w3arycod3r/neodriver-ornament/img/bb_test1.jpg

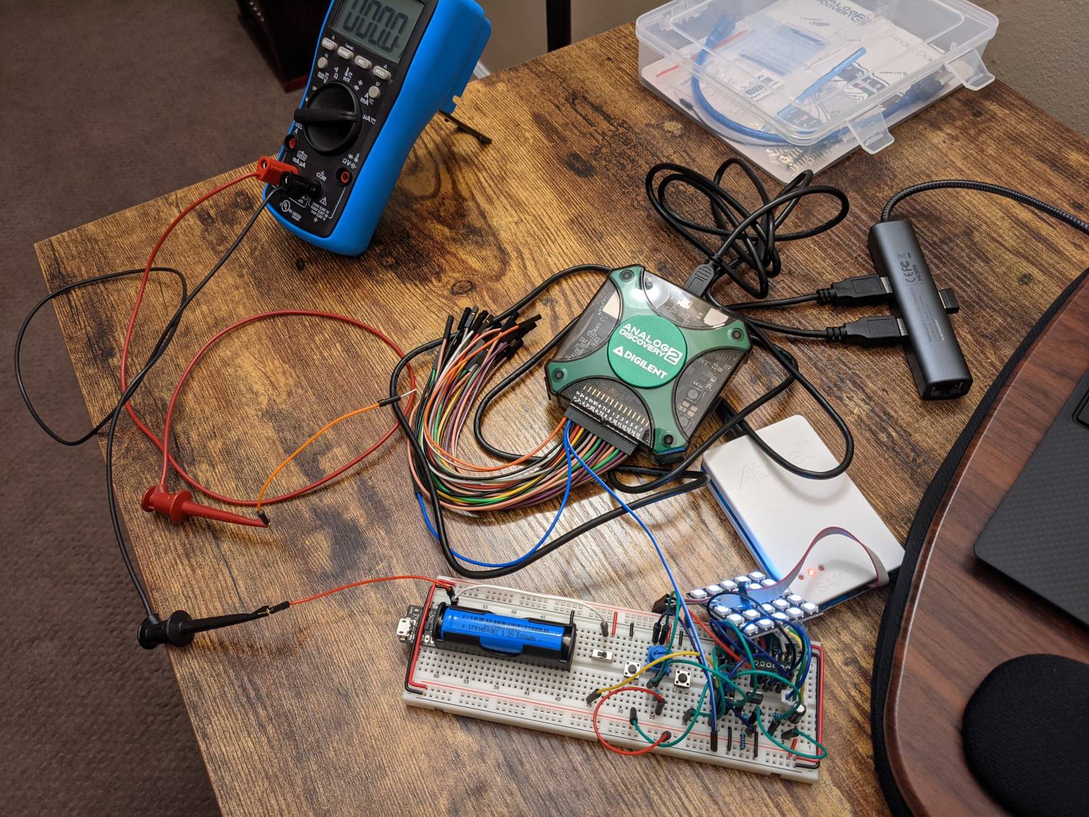
img/bb_test1.jpg
