w3arycod3r/neodriver-ornament/img/test1.jpg

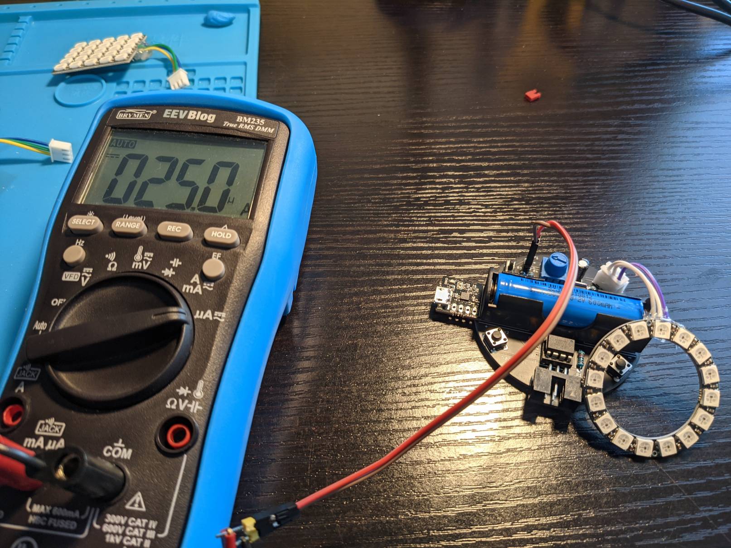
img/test1.jpg
