w3arycod3r/neodriver-ornament/kicad/export/pdf/Neo_Driver v03 Schematic.pdf

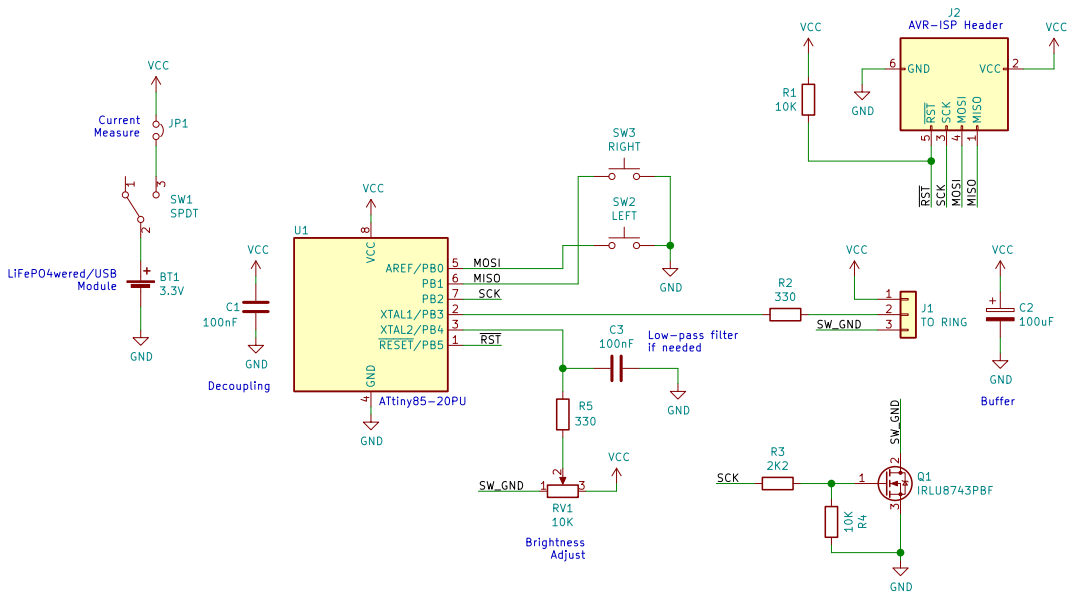
[picture p32: page 1]

AVR-ISP Header LiFePO4wered/USB Module

License: CC BY 4.0 Author: Garrett Carter

File: Neo_Driver.sch Sheet: / creativecommons.org/licenses/by/4.0

Id: 1/1 Title: Neo Driver
