w3arycod3r/neodriver-ornament/kicad/export/pdf/Neo_Driver v02 PCB.pdf

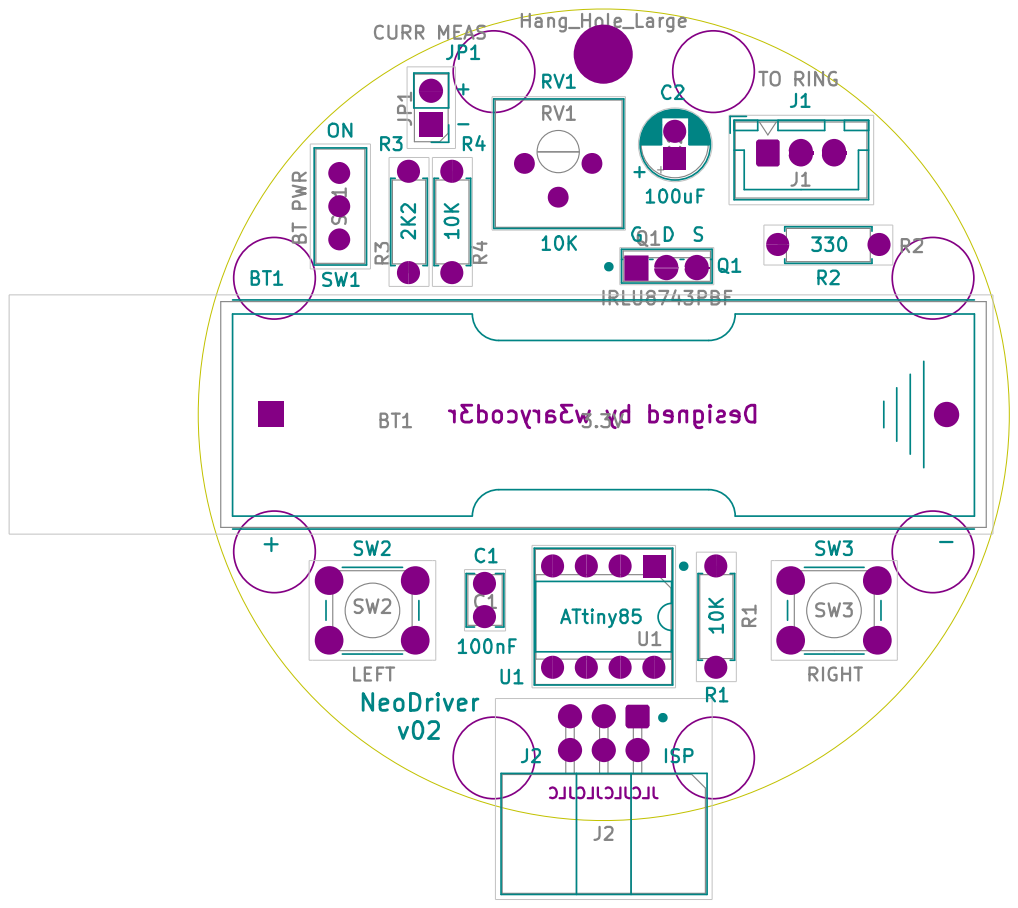
[picture p33: page 1]
