w3arycod3r/neodriver-ornament/kicad/Neo_Driver/Neo_Driver.kicad_pcb

## KiCad design kicad/Neo_Driver/Neo_Driver.kicad_pcb (2021-12-10)

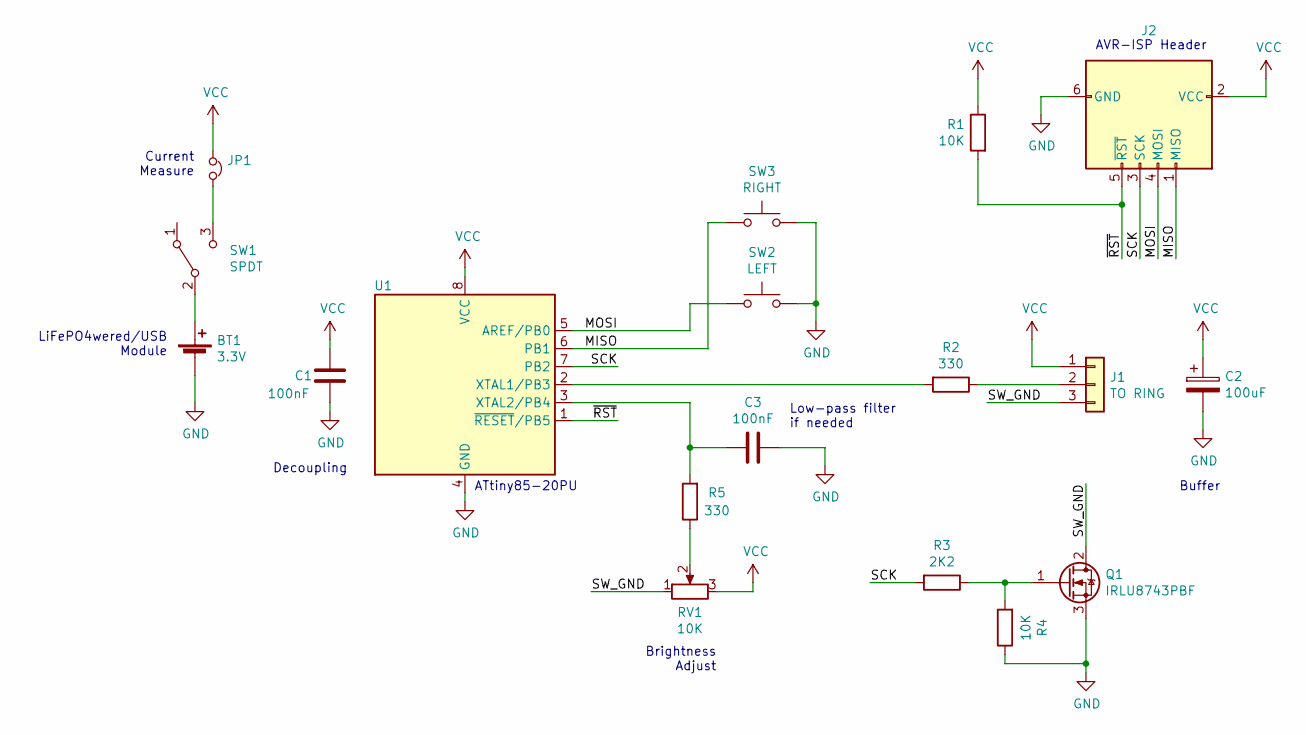
[picture p34: schematic Neo_Driver.sch, Neo Driver]

Parts:
BT1: 3.3V; LiFePO4wered_USB_Slim
C1, C3: 100nF; C_Disc_D3.8mm_W2.6mm_P2.50mm
C2: 100uF; CP_Radial_D5.0mm_P2.00mm
J1: TO RING; JST_XH_B3B-XH-A_1x03_P2.50mm_Vertical
J2: ISP; IDC-Header_2x03_P2.54mm_Horizontal
JP1: CURR MEAS; PinHeader_1x02_P2.54mm_Vertical
Q1: IRLU8743PBF; TO-251-3_Vertical
R1, R4: 10K; R_Axial_DIN0207_L6.3mm_D2.5mm_P7.62mm_Horizontal
R2, R5: 330; R_Axial_DIN0207_L6.3mm_D2.5mm_P7.62mm_Horizontal
R3: 2K2; R_Axial_DIN0207_L6.3mm_D2.5mm_P7.62mm_Horizontal
RV1: 10K; Potentiometer_Bourns_3386P_Vertical
SW1: SPDT; SW_Slide_SPDT_8.6x3.7mm_P2.50mm
SW2: LEFT; SW_PUSH_6mm_H5mm
SW3: RIGHT; SW_PUSH_6mm_H5mm
U1: ATtiny85; DIP-8_W7.62mm_Socket

Connections:
/MISO: J2.1 (MISO), SW3.1, U1.6 (PB1)
/MOSI: J2.4 (MOSI), SW2.1, U1.5 (AREF/PB0)
/SCK: J2.3 (SCK), R3.2, U1.7 (PB2)
/SW_GND: J1.3, Q1.2 (D), RV1.1
/~RST: J2.5 (~RST), R1.2, U1.1 (~RESET~/PB5)
GND: BT1.2 (-), C1.2, C2.2, C3.1, J2.6 (GND), Q1.3 (S), R4.1, SW2.2, SW3.2, U1.4 (GND)
unnamed: BT1.1 (+), SW1.2 (B)
unnamed: C3.2, R5.2, U1.3 (XTAL2/PB4)
unnamed: J1.2, R2.1
unnamed: JP1.2, SW1.3 (C)
unnamed: Q1.1 (G), R3.1, R4.2
unnamed: R2.2, U1.2 (XTAL1/PB3)
unnamed: R5.1, RV1.2
VCC: C1.1, C2.1, J1.1, J2.2 (VCC), JP1.1, R1.1, RV1.3, U1.8 (VCC)

Notes on the sheet:
Decoupling
Buffer
Low-pass filter if needed
LiFePO4wered/USB Module
Brightness Adjust
Current Measure
ATtiny85-20PU
AVR-ISP Header

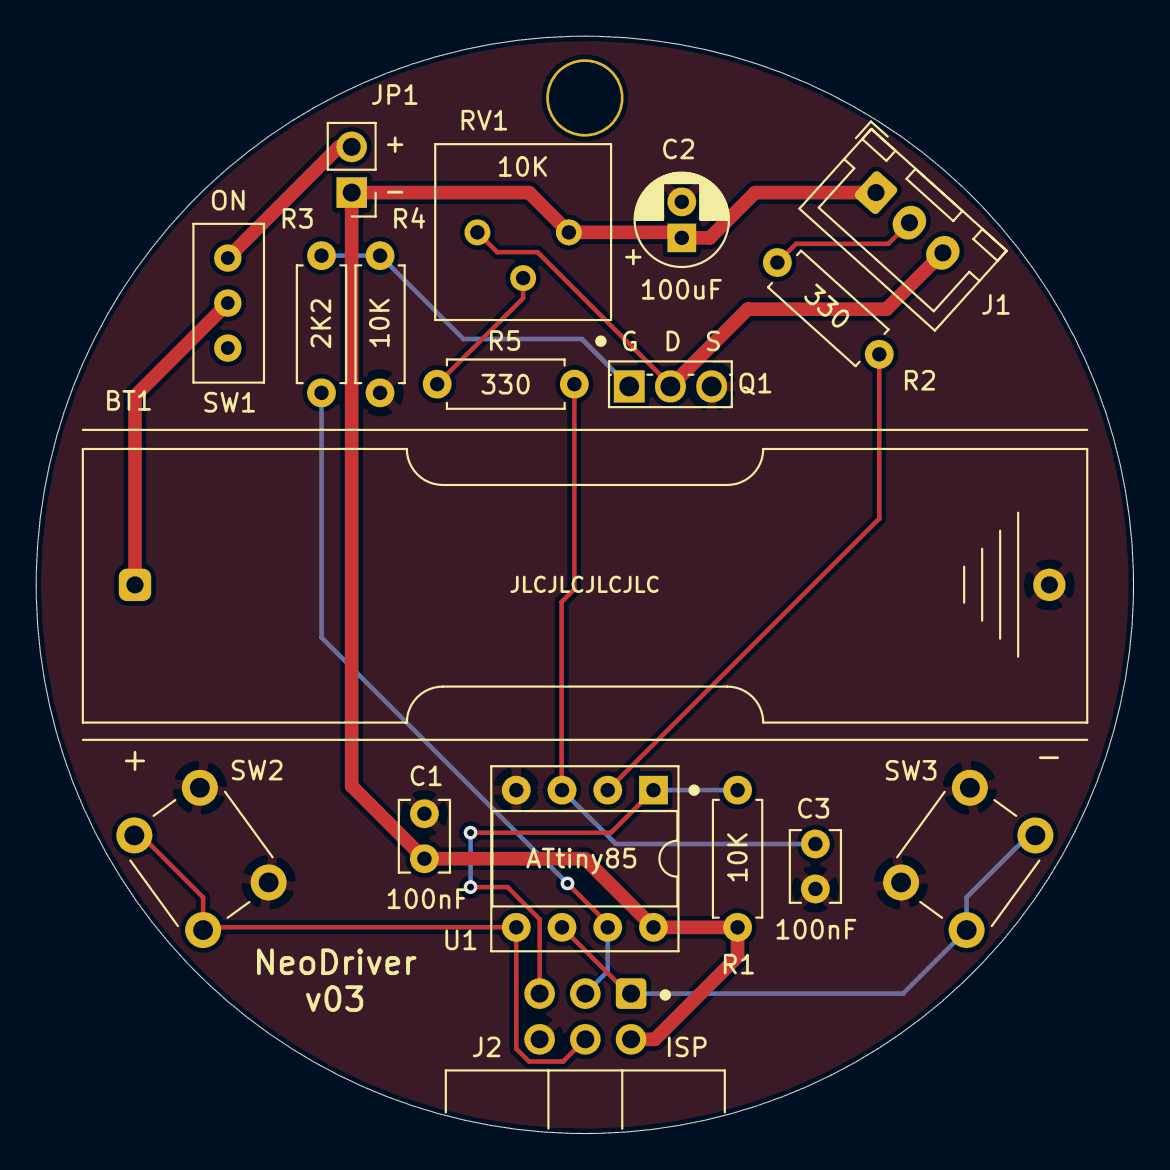
[picture p35: board Neo_Driver.kicad_pcb from above]

Board: 2 copper layers, 61.0 x 61.0 mm, 18 parts (0 on the bottom side), 14 nets.
