w3arycod3r/neodriver-ornament/arduino/neo_driver_app/neo_driver_app.ino

/* File:      neo_driver_app.ino
 * Author:    Garrett Carter
 * Purpose:   Main NeoPixel driver program.
 */

/*
 *  FUSE SETTINGS:
 *  EESAVE    ENABLE
 *  BODLEVEL  ENABLE at VCC = 1.8V
 *  CKDIV8    DISABLE
 *  SUT_CKSEL INTRCOSC_8MHZ_6CK_14CK_64MS
 *
 *  EXTENDED  0xFF
 *  HIGH      0xD6
 *  LOW       0xE2
 */

/********************************* INCLUDES **********************************/
#include <Arduino.h>
#include <EEPROM.h>
#include <avr/power.h>
#include <avr/interrupt.h>
#include <avr/sleep.h>
#include <avr/wdt.h>
#include "neo_pixel_slim.h"
#include "multi_button.h"
#include <neo_common.h>

/*********************************** ENUMS ***********************************/
typedef enum { SYS_MODE_ANIM_SEL,       // Play one selected animation.
               SYS_MODE_ANIM_SHUFF,     // "Shuffle mode". Play randomly selected animations in turn.
               SYS_MODE_PIX_ADJ,        // Adjust number of pixels.
} _SYS_MODE_T;

typedef enum { FRAMES_MODE_STATIC,      // Sprite is stationary. Length determined by repeat count.
               FRAMES_MODE_SHIFT,       // Shift the sprite. Anim is terminated when sprite goes offscreen.
} _FRAMES_MODE_T;

/********************************** STRUCTS **********************************/
typedef struct {
    uint16_t u16_frameStep_msec;  // "on" time for each frame in the sequence.
    uint32_t u32_color;           // Color. Set to 0 for dynamic effect.
    uint8_t* pu8_frames;          // Pointer to the frame sequence array stored in flash.
    uint8_t  u8_mode;             // Mode of operation. A value from _FRAMES_MODE_T.

    // STATIC mode params
    uint8_t  u8_seqRepeatCnt;     // Number of times to repeat the frame seq for each anim cycle in STATIC mode.
    
    // SHIFT mode params
    uint8_t  u8_frameShiftSync;   // Number of frames between shifts, in SHIFT mode.
    int8_t   i8_startPosX;        // Init X,Y position. Should start onscreen.
    int8_t   i8_startPosY;        // 
    int8_t   i8_shiftStepX;       // The X shift to perform on each shift step. Can be pos, neg, or zero.
    int8_t   i8_shiftStepY;       // The Y shift to perform on each shift step. Can be pos, neg, or zero.
    
} FRAMES_CONFIG_T;

/********************************** DEFINES **********************************/

// Watchdog timeouts (Actual delays will be slightly longer at 3.3V)
#define WDT_16MS   0
#define WDT_32MS   1
#define WDT_64MS   2
#define WDT_125MS  3
#define WDT_250MS  4
#define WDT_500MS  5
#define WDT_1S     6
#define WDT_2S     7
#define WDT_4S     8
#define WDT_8S     9  // Hardware maximum

// Multiples of 8 sec, software generated
#define WDT_16S    10
#define WDT_24S    11
#define WDT_32S    12
#define WDT_40S    13
#define WDT_48S    14
#define WDT_56S    15

// Battery params
#define BATT_TON_MSEC         2000    // "On" time for low battery timer
#define BATT_DISCHG_THRESH_MV 2500    // Discharge threshold (Cutoff volt. from datasheet = 2.0V)
#define BATT_CHG_THRESH_MV    3000    // Charge threshold (Cutoff volt. from datasheet = 2.0V)

#define BATT_LVL_THRESH_1_MV 2750
#define BATT_LVL_THRESH_2_MV 3000
#define BATT_LVL_THRESH_3_MV 3100
#define BATT_LVL_THRESH_4_MV 3200
#define BATT_LVL_STEP_MSEC   400
#define BATT_LVL_SLEEP_TIME  WDT_8S

#define BATT_ICON_LVL_1     '#'
#define BATT_ICON_LVL_2     '$'
#define BATT_ICON_LVL_3     '%'
#define BATT_ICON_LVL_4     '&'
#define BATT_ICON_LVL_5     '\''
#define BATT_ICON_DEAD      '('

// Pixel params
#define BRIGHT_MIN   24
#define BRIGHT_INIT  8
#define PIX_CNT_MIN  1
#define PIX_CNT_MAX  25
#define PIX_CNT_INIT 25

// Animation params
#define ANIM_CNT (sizeof(apfn_renderFunc) / sizeof(apfn_renderFunc[0]))
#define ANIM_MANUAL_CYCLES     1              // Number of cycles to play in "manual" mode before going to shuffle mode

// Primaries
#define PRIM_ON_TIME_MSEC      6000           // "on" time between sleeps
#define PRIM_SLEEP_TIME        WDT_8S         // Time to sleep after this anim

// Colorwheel
#define COL_WHEEL_ON_TIME_MSEC 6000
#define COL_WHEEL_SLEEP_TIME   WDT_8S

// Half
#define HALF_ON_TIME_MSEC      6000
#define HALF_SLEEP_TIME        WDT_8S

// Sparkle
#define SPK_STEP_MSEC          65             // Time between random pixel change
#define SPK_ON_TIME_MSEC       4000
#define SPK_SLEEP_TIME         WDT_8S

// Marquee
#define MARQUEE_ON_TIME_MSEC   6000
#define MARQUEE_SLEEP_TIME     WDT_8S

// Sine Gamma
#define SINE_ON_TIME_MSEC      6000
#define SINE_SLEEP_TIME        WDT_8S

// CoV
#define COV_STEP_MSEC          1000                   // "On" time for each base
#define COV_STEP_CNT           4                      // Number of steps (bases) per cycle
#define COV_BASES_CNT         (EEP_COV_DATA_NUM_BYTES * 4)     // 4 bases per byte
#define COV_SLEEP_TIME         WDT_8S

// Message Scroll
#define MSG_STEP_MSEC          200                    // Time to shift each char left by one pixel
#define MSG_SLEEP_TIME         WDT_24S

// Frames
#define FRAMES_SLEEP_TIME      WDT_8S

/*
 *   ANIM_ROT_SEL - Rotation select for 5x5 Matrix - Increasing #, Turning clockwise
 *   Used by several text based animations
 *
 *   Value |  Input wires located at:
 *   ================================
 *   1     |  BOTTOM
 *   2     |  LEFT
 *   3     |  TOP
 *   4     |  RIGHT
 */
#define ANIM_ROT_SEL 3

// I/O Mapping
#define IO_SW_LEFT       BIT0 // PB0, AREF - Left switch
#define IO_SW_RIGHT      BIT1 // PB1       - Right switch
#define IO_NP_ENABLE     BIT2 // PB2, ADC1 - NeoPixel Enable
#define IO_NP_ENABLE_ADC A1
#define IO_NP_DATA       BIT3 // PB3, ADC3 - NeoPixel Data
#define IO_NP_DATA_ADC   A3
#define IO_POT_ADC       A2   // PB4, ADC2 - Brightness Potentiometer
                              // PB5, ADC0 - Reset

/******************************* DEBUG PARAMS ********************************/
#define DEBUG_COV_ANIM  0
#define DEBUG_LOW_BATT  0
#define DEBUG_BATT_LVL  0
#define DEBUG_ADC_VAL   0
#define DEBUG_RAND_SEED 0
#define DEBUG_BRIGHT    0

// Debug CoV animation
#if DEBUG_COV_ANIM == 1
    #define COV_BASES_CNT  10
    #define COV_STEP_MSEC  1000
    #define COV_SLEEP_TIME WDT_125MS
#endif

// Debug low battery
#if DEBUG_LOW_BATT == 1
    #define BATT_TON_MSEC  2000
    #define BATT_DISCHG_THRESH_MV 1000
#endif

// Debug batt level animation
#if DEBUG_BATT_LVL == 1
    #define SPOOF_BATT_LVL 3200
#endif

// Debug brightness
#if DEBUG_BRIGHT == 1
    #define BRIGHT_MIN  0
#endif

/******************************** PROTOTYPES *********************************/
void randomize_anim();
void mode_logic();

void anim_off();
void anim_white();
void anim_primaries();
void anim_colorwheel_gamma();
void anim_half();
void anim_sparkle();
void anim_marquee();
void anim_sine_gamma();
void anim_cov_quar();
void anim_cov_char();
void anim_cov(uint8_t u8_pattType);
void anim_msg_1();
void anim_msg_2();
void anim_msg_3();
void anim_msg_4();
void anim_msg(uint8_t* pu8_msg, uint32_t u32_color=0);
void anim_frames_1();
void anim_frames_2();
void anim_frames_3();
void anim_frames_4();
void anim_frames_5();
void anim_frames_6();
void anim_frames_7();
void anim_frames_8();
void anim_frames_9();
void anim_frames_10();
void anim_frames(FRAMES_CONFIG_T* pst_f);
void anim_batt_level();

ISR(PCINT0_vect);
ISR(WDT_vect);

uint8_t get_batt_level();
void draw_value(uint32_t u32_val, uint32_t u32_maxVal);
void draw_value_binary(uint32_t u32_val);
void check_batt(uint16_t u16_batt_mv);
void enable_pc_ints();
void disable_pc_ints();
void shutdown();
void anim_low_batt();
uint8_t extract_digit(uint16_t u16_val, uint8_t u8_dig);
void anim_voltage(uint16_t u16_mv);
void anim_color_wipe(uint32_t u32_color, uint16_t u16_wait);
void anim_color_count(uint32_t u32_color, uint16_t u16_wait, uint16_t u16_count);
uint16_t read_vcc_mv();
uint8_t read_cov_base(uint16_t u16_baseNum);
void draw_char(char c_char, uint32_t u32_color, int8_t i8_x=0, int8_t i8_y=0);
void wd_enable(uint8_t u8_timeout);
void _wd_hw_enable(uint8_t u8_timeout);
void store_rand_seed();

/****************************** FLASH CONSTANTS ******************************/

// Message Strings
const char PROGMEM sz_msg1[] = "W3ARYCOD3R ";
const char PROGMEM sz_msg2[] = "MERRY XMAS! ";
const char PROGMEM sz_msg3[] = "HAPPY NEW YEAR! ";
const char PROGMEM sz_msg4[] = "u 4 8 15 16 23 42 ";    // Lost "numbers"
// const char PROGMEM sz_msg4[] = "2021 FTW! ";


// Frame ASCII sequences
const char PROGMEM sz_frames1[] = "gh";            // Pacman    ( 12   : gh  )
const char PROGMEM sz_frames2[] = "\"";            // Ghost     ( 1    : "   )
const char PROGMEM sz_frames3[] = "jklmnopq";      // Starburst ( 12345678 : jklmnopq)
const char PROGMEM sz_frames4[] = "rs";            // Frog      ( 12   :  rs )
const char PROGMEM sz_frames5[] = "`a";            // Turbine   ( 12   :  `a )
const char PROGMEM sz_frames6[] = "b/-\\";         // Spinner
const char PROGMEM sz_frames6_alt[] = "\\-/b";     // Spinner ALT
const char PROGMEM sz_frames7[] = "ef";            // DNA       ( 12    :  ef    )
const char PROGMEM sz_frames8[] = ")*+,.";         // Snowfall  ( 12345 :  )*+,. )
const char PROGMEM sz_frames9[] = ":@=[=;";        // Field     ( 12345  :  :;=@[  ) [143532]
const char PROGMEM sz_frames10[] = "]_cdcit";      // Ball      ( 123467 :  ]_cdit )
const char PROGMEM sz_frames10_alt[] = "ticdc_]";  // Ball ALT

/******************************** GLOBAL VARS ********************************/

// uint16_t u16_frameStep_msec;  // "on" time for each frame in the sequence.
// uint32_t u32_color;           // Color. Set to 0 for dynamic effect.
// uint8_t* pu8_frames;          // Pointer to the frame sequence array stored in flash.
// uint8_t  u8_mode;             // Mode of operation. A value from _FRAMES_MODE_T.

// // STATIC mode params
// uint8_t  u8_seqRepeatCnt;     // Number of times to repeat the frame seq for each anim cycle in STATIC mode.

// // SHIFT mode params
// uint8_t  u8_frameShiftSync;   // Number of frames between shifts, in SHIFT mode.
// int8_t   i8_startPosX;        // Init X,Y position. Should start onscreen.
// int8_t   i8_startPosY;        // 
// int8_t   i8_shiftStepX;       // The X shift to perform on each shift step. Can be pos, neg, or zero.
// int8_t   i8_shiftStepY;       // The Y shift to perform on each shift step. Can be pos, neg, or zero.

// Frame sequence config data

// Sequence 1 - Pacman
FRAMES_CONFIG_T st_sequence1 = {
    200,
    COLOR_YELLOW,
    sz_frames1,
    FRAMES_MODE_SHIFT,

    // STATIC params
    0,

    // SHIFT params
    2,
    -4,
    0,
    1,
    0
};

// Sequence 2 - Ghost
FRAMES_CONFIG_T st_sequence2 = {
    250,
    COLOR_TEAL,
    sz_frames2,
    FRAMES_MODE_SHIFT,

    // STATIC params
    0,

    // SHIFT params
    1,
    -4,
    0,
    1,
    0
};

// Sequence 3 - Starburst
FRAMES_CONFIG_T st_sequence3 = {
    100,
    COLOR_WHEEL,
    sz_frames3,
    FRAMES_MODE_STATIC,

    // STATIC params
    1,

    // SHIFT params
    0,
    0,
    0,
    0,
    0
};

// Sequence 4 - Frog
FRAMES_CONFIG_T st_sequence4 = {
    250,
    COLOR_GREEN,
    sz_frames4,
    FRAMES_MODE_SHIFT,

    // STATIC params
    0,

    // SHIFT params
    1,
    -4,
    0,
    1,
    0
};

// Sequence 5 - Turbine
FRAMES_CONFIG_T st_sequence5 = {
    250,
    COLOR_WHEEL,
    sz_frames5,
    FRAMES_MODE_STATIC,

    // STATIC params
    7,

    // SHIFT params
    0,
    0,
    0,
    0,
    0
};

// Sequence 6 - Spinner
FRAMES_CONFIG_T st_sequence6 = {
    250,
    COLOR_WHEEL,
    sz_frames6,
    FRAMES_MODE_STATIC,

    // STATIC params
    7,

    // SHIFT params
    0,
    0,
    0,
    0,
    0
};

// Sequence 7 - DNA
FRAMES_CONFIG_T st_sequence7 = {
    250,
    COLOR_WHEEL,
    sz_frames7,
    FRAMES_MODE_STATIC,

    // STATIC params
    6,

    // SHIFT params
    0,
    0,
    0,
    0,
    0
};

// Sequence 8 - Snowfall
FRAMES_CONFIG_T st_sequence8 = {
    300,
    COLOR_TEAL,
    sz_frames8,
    FRAMES_MODE_STATIC,

    // STATIC params
    4,

    // SHIFT params
    0,
    0,
    0,
    0,
    0
};

// Sequence 9 - Field
FRAMES_CONFIG_T st_sequence9 = {
    400,
    COLOR_WHEEL,
    sz_frames9,
    FRAMES_MODE_STATIC,

    // STATIC params
    5,

    // SHIFT params
    0,
    0,
    0,
    0,
    0
};

// Sequence 10 - Ball
FRAMES_CONFIG_T st_sequence10 = {
    150,
    COLOR_YELLOW,
    sz_frames10,
    FRAMES_MODE_STATIC,

    // STATIC params
    1,

    // SHIFT params
    0,
    0,
    0,
    0,
    0
};

// Misc vars
uint8_t u8_anim = 0;                   // Index of current anim in table
uint8_t u8_mode = SYS_MODE_ANIM_SEL;   // Current mode
uint16_t au16_pow10[] = { 1, 10, 100, 1000, 10000 }; // Powers of 10 used for B2D
bool b_animReset = true;               // Used to inform animations to reset
bool b_animCycleComplete = false;      // Signal from animations to mode logic
uint8_t au8_pixelData[PIX_CNT_MAX*3];  // 3 bytes of color data per pixel
uint32_t u32_randSeed;
volatile uint8_t u8_wdtCounter = 0;    // Used in WDT ISR
uint8_t u8_nextSleepTime = WDT_16MS;
volatile bool b_pinChangeWake = false; // Signal from pin change ISR to mode logic

// "noinit" section. Vars in this section are not cleared to zero at startup.

// Array of function pointers, in order of cycle
void (*apfn_renderFunc[])(void) {
    //anim_off,
    //anim_white,
    anim_primaries, anim_colorwheel_gamma,
    // anim_half,
    anim_sparkle,
    // anim_marquee, anim_sine_gamma,
    // anim_cov_quar,
    anim_cov_char,
    anim_msg_1,
    anim_msg_2,
    anim_msg_3,
    anim_msg_4,
    anim_frames_1,
    anim_frames_2,
    anim_frames_3,
    anim_frames_4,
    anim_frames_5,
    anim_frames_6,
    anim_frames_7,
    anim_frames_8,
    anim_frames_9,
    anim_frames_10,
    anim_batt_level,
};

/****************************** GLOBAL OBJECTS *******************************/
NeoPixel_Slim o_strip(au8_pixelData, PIX_CNT_MAX, PIX_CNT_INIT, IO_NP_DATA);
multiButton o_leftBtn, o_rightBtn;

/****************************** SETUP FUNCTION *******************************/
void setup() {
    // Disable unused peripherals to save power in ACTIVE mode

    // The below assignments should be equivalent to RESET values
    // TCCR1 = 0;                                                     // Disable TIMER1
    // GTCCR = 0;                                                     // Disable TIMER1
    // bitClearMask( TIMSK, _BV(OCIE1A) | _BV(OCIE1B) | _BV(TOIE1) ); // Disable all TIMER1 ints
    // PLLCSR = 0;                                                    // Disable PLL
    // USICR = 0;                                                     // Disable USI

    ACSR = _BV(ACD);                                               // Disable analog comparator
    bitSetMask( DIDR0, _BV(ADC2D) );                               // Disable digital input buffer on ADC2
    bitSetMask( PRR, _BV(PRTIM1) | _BV(PRUSI) );                   // Disable TIMER1, USI clocks

    // Read EEPROM settings data
    uint8_t u8_rPix = EEPROM.read(EEP_SETT_NPIX);
    uint8_t u8_rAnim = EEPROM.read(EEP_SETT_ANIM);
    EEPROM.get(EEP_SETT_RSEED, u32_randSeed);

    // Validate pixel count from EEPROM
    if (u8_rPix > PIX_CNT_MAX || u8_rPix < PIX_CNT_MIN) {
        u8_rPix = PIX_CNT_INIT;
        EEPROM.write(EEP_SETT_NPIX, u8_rPix);
    }

    // Validate animation number from EEPROM
    if (u8_rAnim >= ANIM_CNT) {
        u8_rAnim = 0;
        EEPROM.write(EEP_SETT_ANIM, u8_rAnim);
    }

    // Seed PRNG with a number derived from a source of entropy (human input)
    randomSeed(u32_randSeed ^ read_vcc_mv());
    
    // Update state using EEPROM data
    o_strip.update_length(u8_rPix);
    u8_anim = u8_rAnim;

    // Setup I/O
    bitSetMask(DDRB, IO_NP_ENABLE);               // Set as o/p
    bitSetMask(PORTB, IO_NP_ENABLE);              // Enable MOSFET for NeoPixel power
    delay(5);                                     // Time for MOSFET to switch on
    bitClearMask(DDRB, IO_SW_LEFT | IO_SW_RIGHT); // Set as i/p
    bitSetMask(PORTB, IO_SW_LEFT | IO_SW_RIGHT);  // Enable pull-ups

    // Init and clear NeoPixels
    o_strip.begin();
    o_strip.show();
    o_strip.set_brightness(BRIGHT_INIT);

    // Init Vars

    // Debug code
    #if DEBUG_ADC_VAL == 1
        while(1) {
            delay(250);
            analogReference(DEFAULT);
            //draw_value(analogRead(IO_POT_ADC), 1023);
            draw_value(read_vcc_mv(), 3500);
            o_strip.show();
        }
    #endif

    #if DEBUG_RAND_SEED == 1
        draw_value_binary(u32_randSeed ^ read_vcc_mv());
        o_strip.show();
        delay(3000);
    #endif
    

}

/********************************* MAIN LOOP *********************************/
void loop() {

    // Set brightness from potentiometer value
    uint16_t u16_potVal = analogRead(IO_POT_ADC);
    uint8_t u8_bright = o_strip.get_gamma_8(map(u16_potVal, 0, 1023, BRIGHT_MIN, 255)); // Scale value
    o_strip.set_brightness(u8_bright);

    // Monitor vcc for low batt condition
    check_batt(read_vcc_mv());

    // Update "random" counter based on human interface 
    if ( (!bitReadMask(PINB, IO_SW_LEFT)) || (!bitReadMask(PINB, IO_SW_RIGHT)) ) {
        u32_randSeed++;
    }

    mode_logic();

    if ( (u8_mode == SYS_MODE_ANIM_SEL) || (u8_mode == SYS_MODE_ANIM_SHUFF) ) {
        (*apfn_renderFunc[u8_anim])();    // Render one frame in current anim
        o_strip.show();                   // and update the NeoPixels to show it
    }
    if (u8_mode == SYS_MODE_PIX_ADJ) {
        o_strip.fill(0xFF0000);
        o_strip.show();
    }

}

void randomize_anim() {
    uint8_t u8_newAnim;

    // Pick a new random animation, different from the current one
    do { u8_newAnim = random(ANIM_CNT); } while (u8_newAnim == u8_anim);

    u8_anim = u8_newAnim;
    
    // Randomly shuffle animation parameters
    uint8_t u8_direction = random(2); // 0 or 1

    if (u8_direction) {

        // Reverse ghost direction
        st_sequence2.i8_startPosX = -st_sequence2.i8_startPosX;
        st_sequence2.i8_shiftStepX = -st_sequence2.i8_shiftStepX;

        // Reverse frog direction
        st_sequence4.i8_startPosX = -st_sequence4.i8_startPosX;
        st_sequence4.i8_shiftStepX = -st_sequence4.i8_shiftStepX;

        // Reverse spinner direction
        st_sequence6.pu8_frames = sz_frames6_alt;
        
        // Reverse ball direction
        st_sequence10.pu8_frames = sz_frames10_alt;

    } else {

        // Restore spinner direction
        st_sequence6.pu8_frames = sz_frames6;

        // Restore ball direction
        st_sequence10.pu8_frames = sz_frames10;
    }
}

void mode_logic() {
    static uint8_t u8_animCycleCount = 0;

    // Handle power down after an animation cycle
    if (b_animCycleComplete) {
        b_animCycleComplete = false;
        u8_animCycleCount++;

        wd_enable(u8_nextSleepTime); // Value set by the terminating animation
        shutdown();

        // Don't randomize if we woke with switch
        if (u8_mode == SYS_MODE_ANIM_SHUFF && !b_pinChangeWake) {
            randomize_anim();
        }
        b_pinChangeWake = false;
        b_animReset = true;
    }

    // Switch to shuffle mode after playing a few cycles of the manually selected anim
    if (u8_mode == SYS_MODE_ANIM_SEL && u8_animCycleCount == ANIM_MANUAL_CYCLES-1) {
        u8_mode = SYS_MODE_ANIM_SHUFF;
    }

    // Update button events
    uint8_t u8_lEvent = o_leftBtn.check(bitReadMask(PINB, IO_SW_LEFT));
    uint8_t u8_rEvent = o_rightBtn.check(bitReadMask(PINB, IO_SW_RIGHT));

    // Respond to left button events
    switch (u8_lEvent)
    {
    // Click
    case 1:

        if (u8_mode == SYS_MODE_ANIM_SEL || u8_mode == SYS_MODE_ANIM_SHUFF)
        {
            u8_mode = SYS_MODE_ANIM_SEL;
            u8_animCycleCount = 0;

            if (u8_anim) { u8_anim--; }               // Go to prior anim
            else         { u8_anim = ANIM_CNT - 1; }  // or "wrap around" to last anim

            b_animReset = true;

            EEPROM.update(EEP_SETT_ANIM, u8_anim);
            store_rand_seed();
        }

        if (u8_mode == SYS_MODE_PIX_ADJ)
        {
            // Reduce numPixels by 1
            uint8_t u8_numPix = o_strip.get_length();
            if (u8_numPix >= PIX_CNT_MIN + 1)  { u8_numPix -= 1; }
            else                               { u8_numPix = PIX_CNT_MIN; }

            o_strip.clear();
            o_strip.show();
            o_strip.update_length(u8_numPix);
        }

        break;
    // Double Click
    case 2:

        if (u8_mode == SYS_MODE_PIX_ADJ)
        {
            // Reduce numPixels by 4
            uint8_t u8_numPix = o_strip.get_length();
            if (u8_numPix >= PIX_CNT_MIN + 4)  { u8_numPix -= 4; }
            else                               { u8_numPix = PIX_CNT_MIN; }

            o_strip.clear();
            o_strip.show();
            o_strip.update_length(u8_numPix);
        }

        break;
    // Hold
    case 3:

        break;
    // Long Hold
    case 4:

        if (u8_mode == SYS_MODE_ANIM_SEL || u8_mode == SYS_MODE_ANIM_SHUFF) {
            u8_mode = SYS_MODE_PIX_ADJ;
        }
        else if (u8_mode == SYS_MODE_PIX_ADJ) {
            EEPROM.update(EEP_SETT_NPIX, o_strip.get_length());
            u8_mode = SYS_MODE_ANIM_SEL;
        }

        break;
    }

    // Respond to right button events
    switch (u8_rEvent)
    {
    // Click
    case 1:

        if (u8_mode == SYS_MODE_ANIM_SEL || u8_mode == SYS_MODE_ANIM_SHUFF)
        {
            u8_mode = SYS_MODE_ANIM_SEL;
            u8_animCycleCount = 0;

            if (u8_anim < (ANIM_CNT - 1)) { u8_anim++;   }  // Advance to next anim
            else                          { u8_anim = 0; }  // or "wrap around" to start

            b_animReset = true;

            EEPROM.update(EEP_SETT_ANIM, u8_anim);
            store_rand_seed();
        }

        if (u8_mode == SYS_MODE_PIX_ADJ)
        {
            // Increase numPixels by 1
            uint8_t u8_numPix = o_strip.get_length();
            if (u8_numPix <= PIX_CNT_MAX - 1)  { u8_numPix += 1; }
            else                               { u8_numPix = PIX_CNT_MAX; }

            o_strip.update_length(u8_numPix);
        }


        break;
    // Double Click
    case 2:

        if (u8_mode == SYS_MODE_PIX_ADJ)
        {
            // Increase numPixels by 4
            uint8_t u8_numPix = o_strip.get_length();
            if (u8_numPix <= PIX_CNT_MAX - 4)  { u8_numPix += 4; }
            else                               { u8_numPix = PIX_CNT_MAX; }

            o_strip.update_length(u8_numPix);
        }

        break;
    // Hold
    case 3:

        break;
    // Long Hold
    case 4:
        if (u8_mode == SYS_MODE_ANIM_SEL || u8_mode == SYS_MODE_ANIM_SHUFF) {
            u8_mode = SYS_MODE_PIX_ADJ;
        }
        else if (u8_mode == SYS_MODE_PIX_ADJ) {
            EEPROM.update(EEP_SETT_NPIX, o_strip.get_length());
            u8_mode = SYS_MODE_ANIM_SEL;
        }

        break;
    }
}

/***************************** RENDER FUNCTIONS ******************************/

// All NeoPixels off
void anim_off() {
    o_strip.clear();
}

void anim_white() {
    o_strip.fill(0xFFFFFF);
}

// Cycle through primary colors (red, green, blue), full brightness.
void anim_primaries() {
    static uint16_t u16_startTime;
    static uint8_t u8_direction;        // Direction of the anim. (0, 1 : CW, CCW)
    uint32_t u32_color;
    uint16_t u16_currTime = millis();
    uint16_t u16_currTimeMod = u16_currTime;
    uint8_t  u8_numPixels = o_strip.get_length();

    // Reset static vars to starting values
    if (b_animReset) {
        b_animReset = false;

        u16_startTime = u16_currTime;
        u8_direction = random(2); // 0 or 1
    }

    // For unsigned n-bit int i: -(i) = (2^n - i)
    // Negating this value will cause it to decrease instead of increase with time
    if (u8_direction) { u16_currTimeMod = -u16_currTimeMod; }

    // Generate time-modulated animation
    for (uint8_t u8_pixIdx = 0; u8_pixIdx < u8_numPixels; u8_pixIdx++) {
        uint8_t u8_pixIdxMod = u8_pixIdx;

        // Time modulated pixel index
        // Tick every 100 mSec
        u8_pixIdxMod = ((u16_currTimeMod / 100) + u8_pixIdxMod) % u8_numPixels;

        // Approx 1/3 R,G,B at any one time
        // Where does our modulated pixel index fall on the color wheel?
        if      (u8_pixIdxMod < u8_numPixels/3)    u32_color = 0xFF0000; // Red
        else if (u8_pixIdxMod < 2*u8_numPixels/3)  u32_color = 0x00FF00; // Green
        else                                       u32_color = 0x0000FF; // Blue
        o_strip.set_pix_color(u8_pixIdx, u32_color);
    }

    // Signal mode logic of cycle completion
    if (u16_currTime - u16_startTime > PRIM_ON_TIME_MSEC) {
        b_animCycleComplete = true;

        u8_nextSleepTime = PRIM_SLEEP_TIME;
    }
}

// Color wheel using gamma-corrected values.
void anim_colorwheel_gamma() {
    static uint16_t u16_startTime;
    static uint8_t u8_direction;        // Direction of the anim. (0, 1 : CW, CCW)
    uint16_t u16_currTime = millis();
    uint16_t u16_currTimeMod = u16_currTime;
    uint8_t  u8_numPixels = o_strip.get_length();

    // Reset static vars to starting values
    if (b_animReset) {
        b_animReset = false;

        u16_startTime = u16_currTime;
        u8_direction = random(2); // 0 or 1
    }

    // For unsigned n-bit int i: -(i) = (2^n - i)
    // Negating this value will cause it to decrease instead of increase with time
    if (u8_direction) { u16_currTimeMod = -u16_currTimeMod; }

    // Generate time-modulated animation
    for (uint8_t u8_pixIdx = 0; u8_pixIdx < u8_numPixels; u8_pixIdx++) {
        o_strip.set_pix_color(u8_pixIdx,
        o_strip.get_gamma_32(o_strip.hsv_to_pack((u16_currTimeMod * 50) + u8_pixIdx * 65536L / u8_numPixels)));
    }

    // Signal mode logic of cycle completion
    if (u16_currTime - u16_startTime > COL_WHEEL_ON_TIME_MSEC) {
        b_animCycleComplete = true;

        u8_nextSleepTime = COL_WHEEL_SLEEP_TIME;
    }
}

// Cycle with half the pixels on, half off at any given time.
void anim_half() {
    static uint16_t u16_startTime;
    static uint8_t u8_direction;        // Direction of the anim. (0, 1 : CW, CCW)
    uint16_t u16_currTime = millis();
    uint16_t u16_currTimeMod = u16_currTime;
    uint8_t  u8_numPixels = o_strip.get_length();

    // Reset static vars to starting values
    if (b_animReset) {
        b_animReset = false;

        u16_startTime = u16_currTime;
        u8_direction = random(2); // 0 or 1
    }

    // For unsigned n-bit int i: -(i) = (2^n - i)
    // Negating this value will cause it to decrease instead of increase with time
    if (u8_direction) { u16_currTimeMod = -u16_currTimeMod; }

    // Generate time-modulated animation
    for (uint8_t u8_pixIdx = 0; u8_pixIdx < u8_numPixels; u8_pixIdx++) {

        // Time modulated pixel index
        uint8_t u8_pixIdxMod = u16_currTimeMod/4 + u8_pixIdx * 256 / u8_numPixels;
        u8_pixIdxMod = (u8_pixIdxMod >> 7) * 255;                     // ON or OFF

        o_strip.set_pix_color(u8_pixIdx, u8_pixIdxMod * 0x010000);
    }

    // Signal mode logic of cycle completion
    if (u16_currTime - u16_startTime > HALF_ON_TIME_MSEC) {
        b_animCycleComplete = true;

        u8_nextSleepTime = HALF_SLEEP_TIME;
    }
}

// Sparkles. Randomly turns on ONE pixel at a time.
void anim_sparkle() {
    static uint16_t u16_startTime;
    static uint16_t u16_lastTime;
    static uint8_t  u8_pixIdx;
    static uint8_t  u8_red;
    static uint8_t  u8_green;
    static uint8_t  u8_blue;
    uint16_t u16_currTime = millis();
    uint8_t  u8_numPixels = o_strip.get_length();

    // Reset static vars to starting values
    if (b_animReset) {
        b_animReset = false;

        u16_startTime = u16_currTime;
        u16_lastTime = u16_currTime;
        u8_pixIdx = 0;

        // Pick a bright enough random color
        do {
            u8_red = random(256);
            u8_green = random(256);
            u8_blue = random(256);
        } while ((u8_red < 130) && (u8_green < 130) && (u8_blue < 130));
    }
    
    // Iterate animation once per step
    if (u16_currTime - u16_lastTime > SPK_STEP_MSEC) {
        u16_lastTime = u16_currTime;

        o_strip.clear();                             // Clear pixels

        uint8_t u8_newPixIdx;
        do { u8_newPixIdx = random(u8_numPixels); }  // Pick a new random pixel
        while (u8_newPixIdx == u8_pixIdx);           // but not the same as last time

        u8_pixIdx = u8_newPixIdx;                    // Save new random pixel index
        o_strip.set_pix_color(u8_pixIdx, u8_red, u8_green, u8_blue);
    }

    // Signal mode logic of cycle completion
    if (u16_currTime - u16_startTime > SPK_ON_TIME_MSEC) {
        b_animCycleComplete = true;

        u8_nextSleepTime = SPK_SLEEP_TIME;
    }
}

// Simple on-or-off "marquee" animation w/ about 50% of pixels lit at once.
void anim_marquee() {
    static uint16_t u16_startTime;
    static uint8_t u8_direction;        // Direction of the anim. (0, 1 : CW, CCW)
    uint16_t u16_currTime = millis();
    uint16_t u16_currTimeMod = u16_currTime;
    uint8_t  u8_numPixels = o_strip.get_length();

    // Reset static vars to starting values
    if (b_animReset) {
        b_animReset = false;

        u16_startTime = u16_currTime;
        u8_direction = random(2); // 0 or 1
    }

    // For unsigned n-bit int i: -(i) = (2^n - i)
    // Negating this value will cause it to decrease instead of increase with time
    if (u8_direction) { u16_currTimeMod = -u16_currTimeMod; }

    // Generate time-modulated animation
    for (uint8_t u8_pixIdx = 0; u8_pixIdx < u8_numPixels; u8_pixIdx++) {

        // Time modulated pixel index
        uint8_t u8_pixIdxMod = (u16_currTimeMod/4 + u8_pixIdx * 256 / u8_numPixels) & 0xFF;
        u8_pixIdxMod = ((u8_pixIdxMod >> 6) & 1) * 255;

        o_strip.set_pix_color(u8_pixIdx, u8_pixIdxMod * 0x000100L);
    }

    // Signal mode logic of cycle completion
    if (u16_currTime - u16_startTime > MARQUEE_ON_TIME_MSEC) {
        b_animCycleComplete = true;

        u8_nextSleepTime = MARQUEE_SLEEP_TIME;
    }
}

// Sine wave with gamma correction.
void anim_sine_gamma() {
    static uint16_t u16_startTime;
    static uint8_t u8_direction;        // Direction of the anim. (0, 1 : CW, CCW)
    uint16_t u16_currTime = millis();
    uint16_t u16_currTimeMod = u16_currTime;
    uint8_t  u8_numPixels = o_strip.get_length();

    // Reset static vars to starting values
    if (b_animReset) {
        b_animReset = false;

        u16_startTime = u16_currTime;
        u8_direction = random(2); // 0 or 1
    }

    // For unsigned n-bit int i: -(i) = (2^n - i)
    // Negating this value will cause it to decrease instead of increase with time
    if (u8_direction) { u16_currTimeMod = -u16_currTimeMod; }

    // Generate time-modulated animation
    for (uint8_t u8_pixIdx = 0; u8_pixIdx < u8_numPixels; u8_pixIdx++) {

        // Time modulated pixel index
        uint8_t u8_pixIdxMod = o_strip.get_sine_8((u16_currTimeMod/4 + u8_pixIdx * 512 / u8_numPixels) & 0xFF);
        u8_pixIdxMod = o_strip.get_gamma_8(u8_pixIdxMod);

        o_strip.set_pix_color(u8_pixIdx, u8_pixIdxMod * 0x000100L);
    }

    // Signal mode logic of cycle completion
    if (u16_currTime - u16_startTime > SINE_ON_TIME_MSEC) {
        b_animCycleComplete = true;

        u8_nextSleepTime = SINE_SLEEP_TIME;
    }
}


// Blink out the SARS-CoV-2 RNA sequence in a "quarter" pattern
void anim_cov_quar() {
    anim_cov(0);
}

// Blink out the SARS-CoV-2 RNA sequence using the charset
void anim_cov_char() {
    anim_cov(1);
}

/*!
 @brief             Supporting function for the CoV sequence animations
 @param u8_pattType 0 = Use "quarter" pattern,
                    1 = Use the charset to represent sequence letters
*/
void anim_cov(uint8_t u8_pattType) {
    static uint16_t u16_baseCnt = 0;
    static uint16_t u16_lastTime;
    static uint8_t  u8_stepCount;

    uint16_t u16_currTime = millis();

    // New transition into this anim, reset vars to starting values
    if (b_animReset) {
        b_animReset = false;

        // Don't reset baseCnt. Retain previous location in the sequence.

        u16_lastTime  = u16_currTime;
        u8_stepCount = 0;
    }

    // Map time elapsed 0-COV_STEP_MSEC (msec) to sine index 0-255
    uint8_t u8_cycle = (u16_currTime - u16_lastTime)*255L / COV_STEP_MSEC;

    // Shift sine wave right by 64 to get off-on-off cycle
    uint8_t u8_cBright = o_strip.get_gamma_8(o_strip.get_sine_8(u8_cycle - 64));

    o_strip.clear();
    uint8_t u8_numPixels = o_strip.get_length();
    uint8_t u8_quarter = u8_numPixels/4;                // Quarter of pixels

    // Render the quarter "slice" (or the char) for the current base, with sine-modulated brightness
    switch (read_cov_base(u16_baseCnt))
    {
    case 0: // A (Grn)
        if      (u8_pattType == 0) { o_strip.fill(u8_cBright * 0x000100L, 0, u8_quarter); }  // Force 32-bit mult
        else if (u8_pattType == 1) { draw_char('A', u8_cBright * 0x000100L); }
        break;
    case 1: // C (Blu)
        if      (u8_pattType == 0) { o_strip.fill(u8_cBright * 0x000001L, u8_quarter, u8_quarter); }
        else if (u8_pattType == 1) { draw_char('C', u8_cBright * 0x000001L); }
        break;
    case 2: // G (Yel)
        if      (u8_pattType == 0) { o_strip.fill(u8_cBright * 0x010100L, 2*u8_quarter, u8_quarter); }
        else if (u8_pattType == 1) { draw_char('G', u8_cBright * 0x010100L); }
        break;
    case 3: // U (Red)
        if      (u8_pattType == 0) { o_strip.fill(u8_cBright * 0x010000L, 3*u8_quarter, 0); }
        else if (u8_pattType == 1) { draw_char('U', u8_cBright * 0x010000L); }
        break;
    }

    // Current step complete
    if (u16_currTime - u16_lastTime > COV_STEP_MSEC) {

        // Prepare for next step. Increment base counter, wrap around if necessary
        u16_baseCnt++;
        if (u16_baseCnt == COV_BASES_CNT) { u16_baseCnt = 0; }
        u16_lastTime = u16_currTime;

        u8_stepCount++;

        // We have played enough steps, so signal cycle completion to the mode logic
        if (u8_stepCount == COV_STEP_CNT) {
            b_animCycleComplete = true;

            u8_nextSleepTime = COV_SLEEP_TIME;
        }
    }
}

// Message string 1
void anim_msg_1() {
    anim_msg(sz_msg1, 0xFF00FF);
}

// Message string 2
void anim_msg_2() {
    anim_msg(sz_msg2);
}

// Message string 3
void anim_msg_3() {
    anim_msg(sz_msg3);
}

// Message string 4
void anim_msg_4() {
    anim_msg(sz_msg4, COLOR_GREEN);
}

/*!
 @brief            Supporting function for the message scroll animations.
 @param pu8_msg    Starting address for a null-terminated C-String with the message, stored in flash.
 @param u32_color  Solid color to use for the characters. Leave at default 0 for a smooth color cycling anim.
*/
void anim_msg(uint8_t* pu8_msg, uint32_t u32_color) {
    static uint8_t  u8_charCnt; // Counts 0 to LEN-1, index into char array
    static uint8_t  u8_cIn;     // Incoming char
    static uint8_t  u8_cOut;    // Outgoing char
    static int8_t   i8_xIn;
    static int8_t   i8_xOut;
    static uint16_t u16_lastTime;
    static bool     b_readyToShutdown;

    uint16_t u16_currTime = millis();

    // New transition into this anim, reset all vars to starting values
    if (b_animReset) {
        b_animReset = false;
        u8_charCnt = 0;
        u8_cIn  = pgm_read_byte(&pu8_msg[0]);
        u8_cOut = ' ';
        i8_xIn  = 5;
        i8_xOut = 0;
        u16_lastTime  = u16_currTime;
        b_readyToShutdown = false;
    }

    // Iterate animation once per step
    if (u16_currTime - u16_lastTime >= MSG_STEP_MSEC) {
        u16_lastTime = u16_currTime;

        if (i8_xIn == 0) {     // Incoming char has reached middle
            u8_cOut = u8_cIn;  // Incoming becomes outgoing

            // Fetch next char
            u8_charCnt++;
            u8_cIn = pgm_read_byte(&pu8_msg[u8_charCnt]);

            // Reached null term, current cycle complete
            if (u8_cIn == 0) {

                b_readyToShutdown = true;
            }

            // Reset positions
            i8_xIn  = 6;
            i8_xOut = 0;
        }

        i8_xIn--; i8_xOut--;  // Shift both chars left
    }

    // Pick color to use
    uint32_t u32_c;
    if (u32_color == 0) { u32_c = o_strip.get_gamma_32(o_strip.hsv_to_pack(u16_currTime*10)); } // Smooth time-modulated color wheel
    else                { u32_c = u32_color; }                                                  // Solid color from calling func

    // Render characters at current pos
    o_strip.clear();
    draw_char(u8_cIn,  u32_c, i8_xIn);
    draw_char(u8_cOut, u32_c, i8_xOut);

    // Signal mode logic of cycle completion
    if (b_readyToShutdown) {
        b_readyToShutdown = false;
        b_animCycleComplete = true;

        u8_nextSleepTime = MSG_SLEEP_TIME;
    }
}

// Frames sequence 1
void anim_frames_1() {
    anim_frames(&st_sequence1);
}

// Frames sequence 2
void anim_frames_2() {
    anim_frames(&st_sequence2);
}

// Frames sequence 3
void anim_frames_3() {
    anim_frames(&st_sequence3);
}

// Frames sequence 4
void anim_frames_4() {
    anim_frames(&st_sequence4);
}

// Frames sequence 5
void anim_frames_5() {
    anim_frames(&st_sequence5);
}

// Frames sequence 6
void anim_frames_6() {
    anim_frames(&st_sequence6);
}

// Frames sequence 7
void anim_frames_7() {
    anim_frames(&st_sequence7);
}

// Frames sequence 8
void anim_frames_8() {
    anim_frames(&st_sequence8);
}

// Frames sequence 9
void anim_frames_9() {
    anim_frames(&st_sequence9);
}

// Frames sequence 10
void anim_frames_10() {
    anim_frames(&st_sequence10);
}

/*!
 @brief         Supporting function for the frames scroll animations.
 @param pst_f   Pointer to the structure containing frames configuration data.
*/
void anim_frames(FRAMES_CONFIG_T* pst_f) {
    static bool     b_readyToShutdown;
    static uint8_t  u8_frameIdx;     // Counts 0 to LEN-1, index into frames array
    static uint8_t  u8_frameShiftSync;
    static uint8_t  u8_seqRepeatCnt; // Counts how many frame seq's we have played
    static uint8_t  u8_currFrame;
    static uint16_t u16_lastFrameTime;
    static int8_t   i8_x;
    static int8_t   i8_y;

    uint16_t u16_currTime = millis();

    // New transition into this anim, reset static vars to starting values
    if (b_animReset) {

        b_animReset = false;
        b_readyToShutdown = false;
        u8_frameIdx = 0;
        u8_frameShiftSync = 0;
        u8_seqRepeatCnt = 0;
        u8_currFrame  = pgm_read_byte(&(pst_f->pu8_frames[0]));
        u16_lastFrameTime  = u16_currTime;

        // Set initial X and Y position of sprite
        if (pst_f->u8_mode == FRAMES_MODE_SHIFT) { i8_x = pst_f->i8_startPosX; i8_y = pst_f->i8_startPosY; }
        else                                     { i8_x =  0; i8_y = 0; }

    }

    // Time for frame update
    if (u16_currTime - u16_lastFrameTime >= pst_f->u16_frameStep_msec) {
        u16_lastFrameTime = u16_currTime;

        // Fetch next frame
        u8_frameIdx++;
        u8_currFrame = pgm_read_byte(&(pst_f->pu8_frames[u8_frameIdx]));

        // Reached null term, current frame cycle complete
        if (u8_currFrame == 0) {

            u8_seqRepeatCnt++;

            // We have repeated the seq the specified number of times
            if ((pst_f->u8_mode == FRAMES_MODE_STATIC) &&
                (u8_seqRepeatCnt == pst_f->u8_seqRepeatCnt)) {
                b_readyToShutdown = true;

            // Prepare for next frame seq
            } else {
                u8_frameIdx = 0;
                u8_currFrame = pgm_read_byte(&(pst_f->pu8_frames[0]));
            }
        }

        // Handle shift
        if (pst_f->u8_mode == FRAMES_MODE_SHIFT) {

            // Count frames and sync shift to frame transition
            u8_frameShiftSync++;
            if (u8_frameShiftSync == pst_f->u8_frameShiftSync) {
                u8_frameShiftSync = 0;

                // Update X and Y position
                i8_x += pst_f->i8_shiftStepX;
                i8_y += pst_f->i8_shiftStepY;
            }
            // We are offscreen, so animation is complete
            if ( (i8_x <= -5) || (i8_x >= 5) || (i8_y <= -5) || (i8_y >= 5) ) {
                b_readyToShutdown = true;
            }
        }
        
    }

    // Pick color to use
    uint32_t u32_color;
    if (pst_f->u32_color == COLOR_WHEEL) {
        u32_color = o_strip.get_gamma_32(o_strip.hsv_to_pack(u16_currTime*10)); // Smooth time-modulated color wheel
    } else {
        u32_color = pst_f->u32_color; // Solid color from spec
    }

    // Render frame
    o_strip.clear();
    draw_char(u8_currFrame, u32_color, i8_x, i8_y);

    // Signal mode logic of cycle completion
    if (b_readyToShutdown) {
        b_readyToShutdown = false;
        b_animCycleComplete = true;

        u8_nextSleepTime = FRAMES_SLEEP_TIME;
    }
}

void anim_batt_level() {
    static uint16_t u16_lastStepTime;
    static uint8_t u8_battLevel;
    static uint8_t u8_stepLevel;
    static bool    b_readyToShutdown;
    uint16_t u16_currTime = millis();

    // Reset static vars to starting values
    if (b_animReset) {
        b_animReset = false;

        u16_lastStepTime = u16_currTime;
        u8_battLevel = get_batt_level();
        u8_stepLevel = 1;
        b_readyToShutdown = false;
    }

    // Step the animation
    if (u16_currTime - u16_lastStepTime > BATT_LVL_STEP_MSEC) {
        u16_lastStepTime = u16_currTime;

        if (u8_stepLevel != u8_battLevel) {
            u8_stepLevel++;

        // Anim complete, power down
        } else {
            
            b_readyToShutdown = true;
        }
    }

    o_strip.clear();

    // Render current frame
    switch (u8_stepLevel)
    {
    case 1:
        draw_char(BATT_ICON_LVL_1, COLOR_RED);
        break;
    case 2:
        draw_char(BATT_ICON_LVL_2, COLOR_YELLOW);
        break;
    case 3:
        draw_char(BATT_ICON_LVL_3, COLOR_YELLOW);
        break;
    case 4:
        draw_char(BATT_ICON_LVL_4, COLOR_GREEN);
        break;
    case 5:
        draw_char(BATT_ICON_LVL_5, COLOR_GREEN);
        break;
    }

    // Signal mode logic of cycle completion
    if (b_readyToShutdown) {
        b_readyToShutdown = false;
        b_animCycleComplete = true;

        u8_nextSleepTime = BATT_LVL_SLEEP_TIME;
    }
}

/*********************************** ISR's ***********************************/

// Left or Right Switch
ISR(PCINT0_vect) {

    // Signal to mode logic
    b_pinChangeWake = true;

    // If we woke up with a switch, we don't want any additional WDT sleeps.
    u8_wdtCounter = 0;
}

// Watchdog timer
ISR(WDT_vect) {

    // Disable WDT interrupt
    bitClear(WDTCR, WDIE);
}

/***************************** SUPPORT FUNCTIONS *****************************/

// Return 1 to 5 corresponding to current battery level: 1 => empty, 5 => full.
uint8_t get_batt_level() {
    uint16_t u16_batt_mv = read_vcc_mv();

    // Determine battery level based on voltage ranges
    if (u16_batt_mv < BATT_LVL_THRESH_1_MV) {
        return 1;
    } else if ( (u16_batt_mv >= BATT_LVL_THRESH_1_MV) && (u16_batt_mv < BATT_LVL_THRESH_2_MV) ) {
        return 2;
    } else if ( (u16_batt_mv >= BATT_LVL_THRESH_2_MV) && (u16_batt_mv < BATT_LVL_THRESH_3_MV) ) {
        return 3;
    } else if ( (u16_batt_mv >= BATT_LVL_THRESH_3_MV) && (u16_batt_mv < BATT_LVL_THRESH_4_MV) ) {
        return 4;
    } else {
        return 5;
    }
}

// Display an integer value (0-maxVal) on the LEDs
void draw_value(uint32_t u32_val, uint32_t u32_maxVal) {

    // Linearly scale the value -> number of pixels to fill
    uint8_t u8_scaledVal = map(u32_val, 0, u32_maxVal, 0, o_strip.get_length());

    o_strip.clear();
    if (u8_scaledVal != 0)  { o_strip.fill(COLOR_PURPLE, 0, u8_scaledVal); }

}

void draw_value_binary(uint32_t u32_val) {
    o_strip.clear();

    // Represent each bit with an ON or OFF pixel, LSB first
    for (uint8_t u8_bit = 0; u8_bit < 32; u8_bit++) {

        // set_pix_color() will enforce pixel index bounds
        if (bitRead(u32_val, 0)) { o_strip.set_pix_color(u8_bit, COLOR_GREEN); }

        u32_val >>= 1;
    }
}

// Check battery level and respond to a low battery condition persisting for some time.
void check_batt(uint16_t u16_batt_mv) {
    static uint16_t u16_onTimeAcc = 0;
    static uint16_t u16_lastScan = 0;
    uint16_t u16_currTime = millis();
    uint8_t u8_statusFlags;
    bool b_shutdown = false;

    u8_statusFlags = EEPROM.read(EEP_SETT_FLAGS);

    // Has the low battery condition been previously detected?
    if (bitReadMask(u8_statusFlags, STAT_FLG_BATT_DEAD))
    {
        // Has battery level risen above the charge threshold?
        if (u16_batt_mv >= BATT_CHG_THRESH_MV)
        {
            // Clear Flag and continue
            EEPROM.update(EEP_SETT_FLAGS, bitClearMask(u8_statusFlags, STAT_FLG_BATT_DEAD));
        } else {
            // Shutdown
            b_shutdown = true;
        }
    }
    
    // Timer Running
    if (u16_batt_mv < BATT_DISCHG_THRESH_MV)
    {
        if (u16_lastScan)  u16_onTimeAcc += (u16_currTime - u16_lastScan);

        u16_lastScan = u16_currTime;
    }
    // Timer Reset
    else
    {
        u16_onTimeAcc = u16_lastScan = 0;
    }
    // Timer Done
    if (u16_onTimeAcc > BATT_TON_MSEC)
    {
        b_shutdown = true;
    }

    // Shutdown
    if (b_shutdown)
    {
        // Set the battery dead flag in EEPROM
        EEPROM.update(EEP_SETT_FLAGS, bitSetMask(u8_statusFlags, STAT_FLG_BATT_DEAD));

        anim_low_batt();
        shutdown();

        u16_onTimeAcc = u16_lastScan = 0; // Timer Reset
    }
    

}

void enable_pc_ints() {

    GIMSK |= _BV(PCIE);                 // Enable Pin Change Interrupts
    PCMSK |= _BV(PCINT0) | _BV(PCINT1); // Enable Specific Pins
}

void disable_pc_ints() {

    PCMSK = 0x00;                       // Disable All Pins
    GIMSK &= ~(_BV(PCIE));              // Disable Pin Change Interrupts
}

// Turn off LEDs and send ATtiny to sleep, waiting for interrupt (WDT or pin change) to wake
void shutdown() {

    o_strip.clear();
    o_strip.show();

    //DIDR0 |= (_BV(ADC2D));               // Disable digital input buffer for ADC2
    bitClearMask(DDRB, IO_NP_DATA          // Hi-Z to save power
                      |IO_NP_ENABLE);      // Hi-Z to turn off MOSFET
    bitSetMask(PORTB, IO_NP_DATA);         // Pull-up
    bitClearMask(PORTB, IO_NP_ENABLE);     // No Pull-up, there is external pull-down

    ADCSRA &= ~(_BV(ADEN));                // Disable ADC

    enable_pc_ints();                      // Wake-up Source
    set_sleep_mode(SLEEP_MODE_PWR_DOWN);
    sleep_enable();

    //sleep_bod_disable();                 // ATtiny85 Revision C or newer only
    sei();                                 // Global Interrupt Enable
    sleep_cpu();
    // Exec PC or WDT ISR, then return here

    // Handle additional WDT sleeps, if needed
    while (u8_wdtCounter > 0) {

        _wd_hw_enable(WDT_8S);
        //sleep_bod_disable();             // ATtiny85 Revision C or newer only
        sei();                             // Global Interrupt Enable
        sleep_cpu();
        // Exec PC or WDT ISR, then return here

        // Counter will be set to 0 if we woke by pin change.
        if (u8_wdtCounter == 0) { break; }

        u8_wdtCounter--;
    }
    
    sleep_disable();
    disable_pc_ints();                     // Don't want these during normal operation

    bitSetMask(DDRB, IO_NP_DATA            // Restore for NeoPixel Lib
                    |IO_NP_ENABLE);
    bitSetMask(PORTB, IO_NP_ENABLE);       // Enable power for NeoPixels
    ADCSRA |= _BV(ADEN);                   // Enable ADC

    // Reset the button state machines
    o_leftBtn.reset();
    o_rightBtn.reset();
}

// Quickly flash red battery icon to indicate low battery condition
void anim_low_batt() {

    o_strip.clear();
    for (uint8_t u8_i = 0; u8_i < 4; u8_i++)
    {
        draw_char(BATT_ICON_DEAD, COLOR_RED);
        o_strip.show();
        delay(200);

        o_strip.clear();
        o_strip.show();
        delay(200);
    }
}

// dig = 0 is LS digit
uint8_t extract_digit(uint16_t u16_val, uint8_t u8_dig) {
    return u16_val / au16_pow10[u8_dig] % 10 ;
}

// Flash the voltage with 3 digits of precision
void anim_voltage(uint16_t u16_mv) {

    for (uint8_t u8_dig = 3; u8_dig >= 1; u8_dig--) // Digits 3 to 1
    {
        uint8_t u8_digVal = extract_digit(u16_mv, u8_dig);
        anim_color_count(o_strip.rgb_to_pack(  0, 255,   0), 150, u8_digVal);
        delay(150 * u8_digVal);

        o_strip.clear();
        o_strip.show();
        delay(300);
    }
}


// Fill o_strip pixels one after another with a color, with a wait in between frames.
void anim_color_wipe(uint32_t u32_color, uint16_t u16_wait) {
    uint8_t u8_numPixels = o_strip.get_length();

    for (uint8_t u8_pixIdx = 0; u8_pixIdx < u8_numPixels; u8_pixIdx++) { // For each pixel in o_strip... 
        o_strip.set_pix_color(u8_pixIdx, u32_color);  //  Set pixel's color (in RAM)
        o_strip.show();                               //  Update o_strip to match
        delay(u16_wait);                              //  Pause for a moment
    }
}

// Fill o_strip pixels with a color, from 0 to count, with a wait in between frames.
void anim_color_count(uint32_t u32_color, uint16_t u16_wait, uint16_t u16_count) {

    for (uint8_t u8_pixIdx = 0; u8_pixIdx < u16_count; u8_pixIdx++) { //  For count # of pixels          
        o_strip.set_pix_color(u8_pixIdx, u32_color); //  Set pixel's color (in RAM)
        o_strip.show();                              //  Update o_strip to match
        delay(u16_wait);                             //  Pause for a moment
    }
}


// Read 1.1V reference against AVcc
uint16_t read_vcc_mv() {

    #if DEBUG_BATT_LVL == 1
        return SPOOF_BATT_LVL;
    #endif

    // Set the reference to Vcc and the measurement to the internal 1.1V reference
    ADMUX = _BV(MUX3) | _BV(MUX2);       // ATtiny85 specific

    delay(2);                            // Wait for Vref to settle
    ADCSRA |= _BV(ADSC);                 // Start conversion
    while (bit_is_set(ADCSRA, ADSC)) {}  // Measuring...

    uint8_t u8_low  = ADCL;              // Must read ADCL first - it then locks ADCH
    uint8_t u8_high = ADCH;              // Unlocks both

    uint16_t u16_result = ((u8_high << 8) | u8_low);

    u16_result = 1125300L / u16_result;  // Calculate Vcc (in mV); 1125300 = 1.1*1023*1000
    return u16_result;                   // Vcc in millivolts
}

// Extract base data from sequence table stored in EEPROM
uint8_t read_cov_base(uint16_t u16_baseNum) {

    // 0th base is encoded in the 2 most significant bits
    uint8_t u8_pos = 3 - u16_baseNum % 4;
    uint8_t u8_data = EEPROM.read(EEP_COV_DATA_START_ADDR + u16_baseNum/4);

    return (u8_data >> (2 * u8_pos)) & 0b00000011;
}

/*!
 @brief            Render an ASCII character onto a 5x5 NeoPixel matrix. Simply draws over the
                   current framebuffer. Destructive only to "on" bits in the font.
                   (X,Y) controls a shift of the char. (0,0) = no shift.
 @param c_char     ASCII character to render.
 @param u32_color  Color to use when setting bits.
 @param i8_x       X shift to perform. +X is right, -X is left. X <= -5 or X >= 5 is out of frame.
 @param i8_y       Y shift to perform. +Y is down, -Y is up. Y <= -5 or Y >= 5 is out of frame.
*/
void draw_char(char c_char, uint32_t u32_color, int8_t i8_x, int8_t i8_y) {

    // Enforce bounds of our ASCII char set
    if ((c_char < ASCII_START) || (c_char > ASCII_START + ASCII_NUM_CHARS - 1)) {
        return;
    }

    uint8_t au8_buffer[5]; // 5x5 framebuffer

    // Copy char data from EEPROM into framebuffer & perform X shift
    for (uint8_t u8_i = 0; u8_i < 5; u8_i++) {
        au8_buffer[u8_i] = eep_char_read_line(c_char, u8_i);

        if      (i8_x < 0) { au8_buffer[u8_i] <<= -i8_x; }   // Shift left
        else if (i8_x > 0) { au8_buffer[u8_i] >>=  i8_x; }   // Shift right
    }

    // Perform Y shift
    if (i8_y != 0) {
        bool shiftDir = true;                                    // True = Down, False = Up
        if (i8_y < 0) { shiftDir = false; i8_y = -i8_y; }        // Make y positive

        for (uint8_t u8_shift = 0; u8_shift < i8_y; u8_shift++)  // Perform y # of shifts
        {
            // Shift down
            if (shiftDir) {
                for (int8_t i8_i = 4; i8_i > 0; i8_i--) {        // i = 4..1
                    au8_buffer[i8_i] = au8_buffer[i8_i - 1];
                }
                au8_buffer[0] = 0;

            // Shift up
            } else {
                for (uint8_t u8_i = 0; u8_i < 4; u8_i++) {       // i = 0..3
                    au8_buffer[u8_i] = au8_buffer[u8_i + 1];
                }
                au8_buffer[4] = 0;
            }
        }
    }

    // Render the framebuffer
    for (uint8_t u8_row = 0; u8_row < 5; u8_row++) {      // Row 0..4, top to bottom
        uint8_t u8_line = au8_buffer[u8_row];             // Get line data from buffer

        for (uint8_t u8_col = 0; u8_col < 5; u8_col++) {  // Col 0..4, right to left
            uint8_t u8_pixIndex;

            // Calculate pixel index from (row,col)
            #if   ANIM_ROT_SEL == 1
                if (u8_col % 2 == 0) { u8_pixIndex = u8_col*5     + 4-u8_row; }
                else                 { u8_pixIndex = u8_col*5     +   u8_row; }
            #elif ANIM_ROT_SEL == 2
                if (u8_row % 2 == 0) { u8_pixIndex = (4-u8_row)*5 + 4-u8_col; }
                else                 { u8_pixIndex = (4-u8_row)*5 +   u8_col; }
            #elif ANIM_ROT_SEL == 3
                if (u8_col % 2 == 0) { u8_pixIndex = (4-u8_col)*5 +   u8_row; }
                else                 { u8_pixIndex = (4-u8_col)*5 + 4-u8_row; }
            #elif ANIM_ROT_SEL == 4
                if (u8_row % 2 == 0) { u8_pixIndex = u8_row*5     +   u8_col; }
                else                 { u8_pixIndex = u8_row*5     + 4-u8_col; }
            #endif


            if (u8_line & 0x01) {
                o_strip.set_pix_color(u8_pixIndex, u32_color); // Extract bit for (row,col)
            }

            u8_line >>= 1; // Next column
        }
    }
}

// Extract a line of a character from the compressed EEPROM char data
// line: 0-4, top-bottom
uint8_t eep_char_read_line(char c_char, uint8_t line)
{
    uint16_t char_index = (c_char - ASCII_START);
    uint16_t bit_start_index = (char_index * MATRIX_NUM_PIX) + (MATRIX_WIDTH_PIX * line);
    // Byte index where beginning of line data is found
    uint16_t byte_start_index = bit_start_index / BITS_IN_BYTE;

    uint16_t byte_start_addr = EEP_CHAR_DATA_START_ADDR + byte_start_index;
    // Bit which is the first bit of the line data (left-most)
    uint16_t bit_within_byte_index = BITS_IN_BYTE - (bit_start_index % BITS_IN_BYTE) - 1;

    // Compose a u16 with first and second bytes, since the line data *may* span two bytes
    uint16_t u16_eep_read = ((EEPROM.read(byte_start_addr) << 8) | EEPROM.read(byte_start_addr+1));
    uint16_t bit_within_word_index = bit_within_byte_index + BITS_IN_BYTE;

    // Extract the 5-bit line data, place in lower 5-bits of the byte to be returned
    uint8_t line_data = (u16_eep_read >> (bit_within_word_index - MATRIX_WIDTH_PIX + 1)) & 0x1F;

    return line_data;
    
}


// External interface for WDT. Call with one of the WDT_XXX constants. Sets up WDT software and hardware.
void wd_enable(uint8_t u8_timeout) {

    // Setup our software counter.
    if (u8_timeout > WDT_8S) {
        u8_wdtCounter = u8_timeout - WDT_8S; // Calculate 8 second repeat count
        u8_timeout = WDT_8S;                 // Set hardware for 8 seconds
    } else {
        u8_wdtCounter = 0;
    }

    _wd_hw_enable(u8_timeout);
}

// Sets up WDT hardware. Enable WDT interrupt and set prescale value.
void _wd_hw_enable(uint8_t u8_timeout) {

    wdt_reset();
    WDTCR = ((1 << WDIE) | ((u8_timeout & 0x8) << 2) | (u8_timeout & 0x7));
}

void store_rand_seed() {

    EEPROM.put(EEP_SETT_RSEED, u32_randSeed);
}
