w3arycod3r/neodriver-ornament/(commit log)

2021-12-10 init push
    [Neo_Driver.kicad_pcb, Neo_Driver.sch]
2021-12-31 Tweaked low battery behavior
2022-09-07 Initial support for pumpkin animation
2022-09-10 Revert "Initial support for pumpkin animation"
    This reverts commit 972e4e4ec1676475467f81d9df17f1b82537a973.
    Halloween changes will be developed in the halloween-additions branch.
    Leave the change to vscode settings
    [eep_data_write.ino, neo_driver_app.ino]
2024-01-19 Optimize eeprom usage (#1)
    * vscode fix for annoying popup :/
    * Move some EEPROM definitions out into a library included by both sketches
    * - rework build scripts
    - Remove extra Sequence data
    - Add conditional compile option for cov sequence data
    - move ard_utility
    - Make define names more detailed
    * eeprom work
    - tweak build scripts
    - add compression and extraction routines
    - rework common defines
    * Correct the line extraction function
    * char set tweaking
    - remove padding in front
    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
    [eep_data_write.ino, neo_driver_app.ino, neo_pixel_slim.h]
2024-02-11 Initial relocation (#2)
    * Initial relocation
    Needs more work...
    Code overflows Flash space by 414 bytes!
    * Remove some unused libraries, replace adafruit neopixel library with the slim version. Refactor the EEP program to use the slim neopixel library
    * Remove some more unused parts of the arduino core
    * Fully move neo pixel slim
    * compilation fixes -- Enable link time optimization (LTO)
    * Combine into a single project
    * Fix configs
    * Remove more unused arduino stuff -- avoid __vector_1 in symbols!
    * cleanup
    * Create separate build config for eep_data_write
    Rework scripts to use AS Makefile and programmer CLI
    * fix paths
    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
    [neo_driver_app.componentinfo.xml]
2024-02-16 replace arduino setup instructions with microchip studio (#4)
    * change arduino setup to microchip studio setup
    * replace back slashes with forward slashes
2024-04-27 remove old arduino scripts
2024-04-27 complete ms-update-fuses.ps1 conversion
2024-08-10 Static function prototypes make no sense in .h files...
2024-08-10 remove some unneeded arduino code.
2024-08-10 More clean up and pruning of the Arduino code
2024-08-11 replace stdlib random with my own prng implementation
    [Arduino.h]
2024-08-11 check voltage script
2024-08-19 fix reversed def of maskhi and masklo -- WARNING: LEDs are now showing as all white, max brightness
2024-08-19 correct nop calculation; np_show is now working well!!
    [Arduino.h]
2024-08-27 work on random prng seeding at startup -- Currently the soft reset is not working, the device is locking up after the soft reset.
    [neo_driver_app.h, wiring_analog.c, wiring_analog.h]
2024-08-27 add DEBUG_SOFT_RESET_ON_INTERVAL_EN; soft reset functionality; cleanup init routine
    [main.c, neo_driver_app.h, wiring.c, wiring_analog.c, wiring_analog.h]
2024-09-02 fix the char drawing bug (it was only setting the first pixel)
    [draw.h, neo_driver_app.h]
2024-09-03 test prng seeding at startup using "random" adc read
2024-09-09 Remake atmel studio project from scratch as a C project
    [neo_driver_app.componentinfo.xml]
2024-09-11 enable warnings and resolve them
    [anim.h, anim_blk.c, debug.h, draw.c, neo_driver_app.c, neo_driver_app.h]
