w3arycod3r/neodriver-ornament/(notices)

Notices in the files:
arduino/neo_driver_app/neo_pixel_slim.cpp:
modify it under the terms of the GNU Lesser General Public License as
published by the Free Software Foundation, either version 3 of the
License, or (at your option) any later version.
microchip-studio/neo_driver_app/arduino_core/wiring_analog.c:
Public License along with this library; if not, write to the
Free Software Foundation, Inc., 59 Temple Place, Suite 330,
Boston, MA 02111-1307 USA
